shehraan/DIY_VR_Controller/Drivers/vr_controller/bin/win64/README.md

Build output target for the SteamVR driver DLL.

Expected file after build:

- `driver_vr_controller.dll`
