shehraan/DIY_VR_Controller/Hardware/Docs/Original-Prototype-Circuit-Drawing.pdf

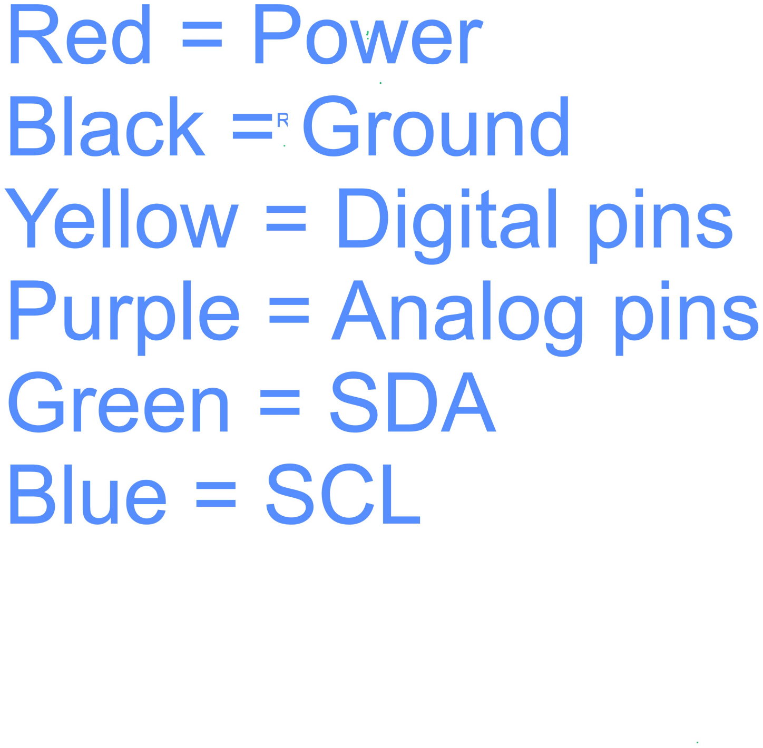
[picture p5: page 1]
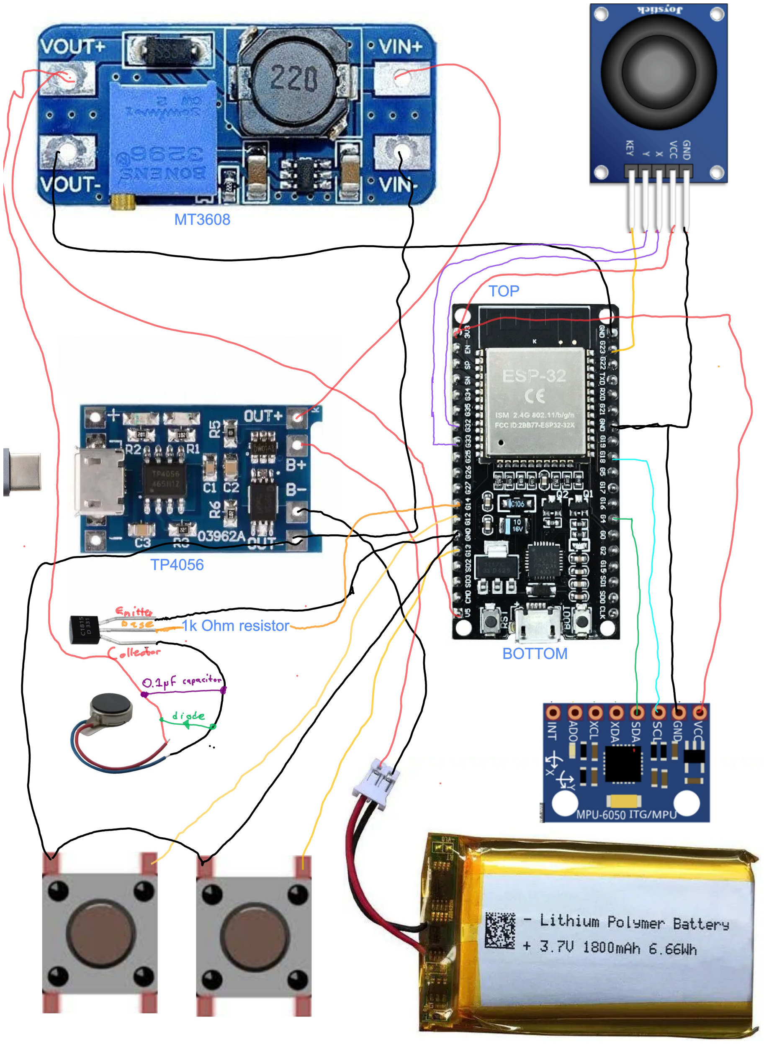
[picture p6: page 2]
