shehraan/DIY_VR_Controller/Hardware/Simulation/Motor-less Wokwi Circuit Files/Circuit Diagram.png

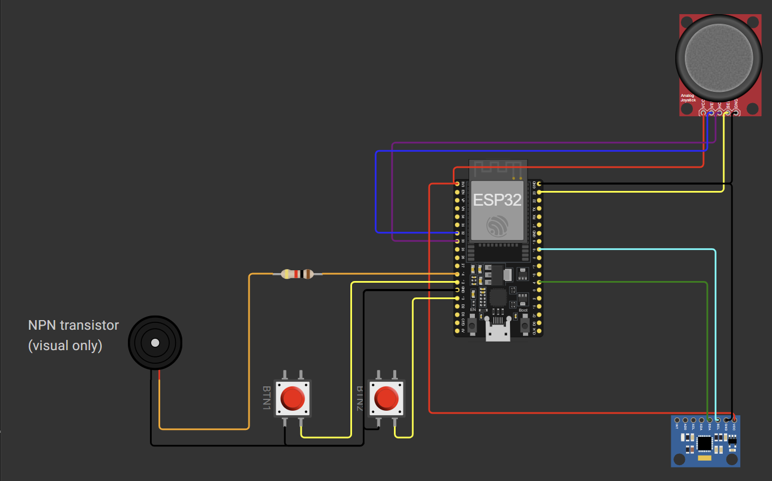
Hardware/Simulation/Motor-less Wokwi Circuit Files/Circuit Diagram.png
