shehraan/DIY_VR_Controller/Hardware/Docs/VR Controller parts list.xlsx

Part Name | Component | Full Price | Link
CPU | ESP-32 dev kit | $25 | https://a.co/d/08W9CSqC
Battery | 2000mah 103450 3.7V LiPo Battery | $20 | https://www.aliexpress.com/item/1005007520210283.html
USB-c Battery Charger | TP4056 Charging Board with Protection | $5 | https://www.aliexpress.com/item/1005006043031985.html
Joystick | PS2 Joycon KY-023 | $4.25 | https://www.aliexpress.com/item/1005006195988088.html
Vibration Motor | VC1030A002F Coin-sized DC motor | $8 | https://www.aliexpress.com/item/1005009934713982.html
Buttons | Gikfun 12x12x7.3mm Tactile Buttons | $16 | https://www.amazon.ca/Gikfun-12x12x7-3-Tactile-Momentary-Arduino/dp/B01E38OS7K
Voltage Boost Module | Mt3608 | $7 | https://www.aliexpress.com/item/1005010404367609.html
Capacitor | 100nf Ceramic Capacitor | $9.85 | https://www.amazon.ca/Tiuimk-100-0-1uF-Ceramic-Capacitor/dp/B0CFTJR3L2
Diode | 1N4001 | $10.53 | https://www.amazon.ca/Projects-General-Purpose-Silicon-Rectifiers/dp/B08JQP945V
IMU | 6DoF MPU-6050 | $3.50 | https://www.ebay.ca/itm/265931676678?chn=ps&google_free_listing_action=view_item
 | Total CAD: | $109.13
