shehraan/DIY_VR_Controller/Hardware/Docs/Controller_Schematic.pdf

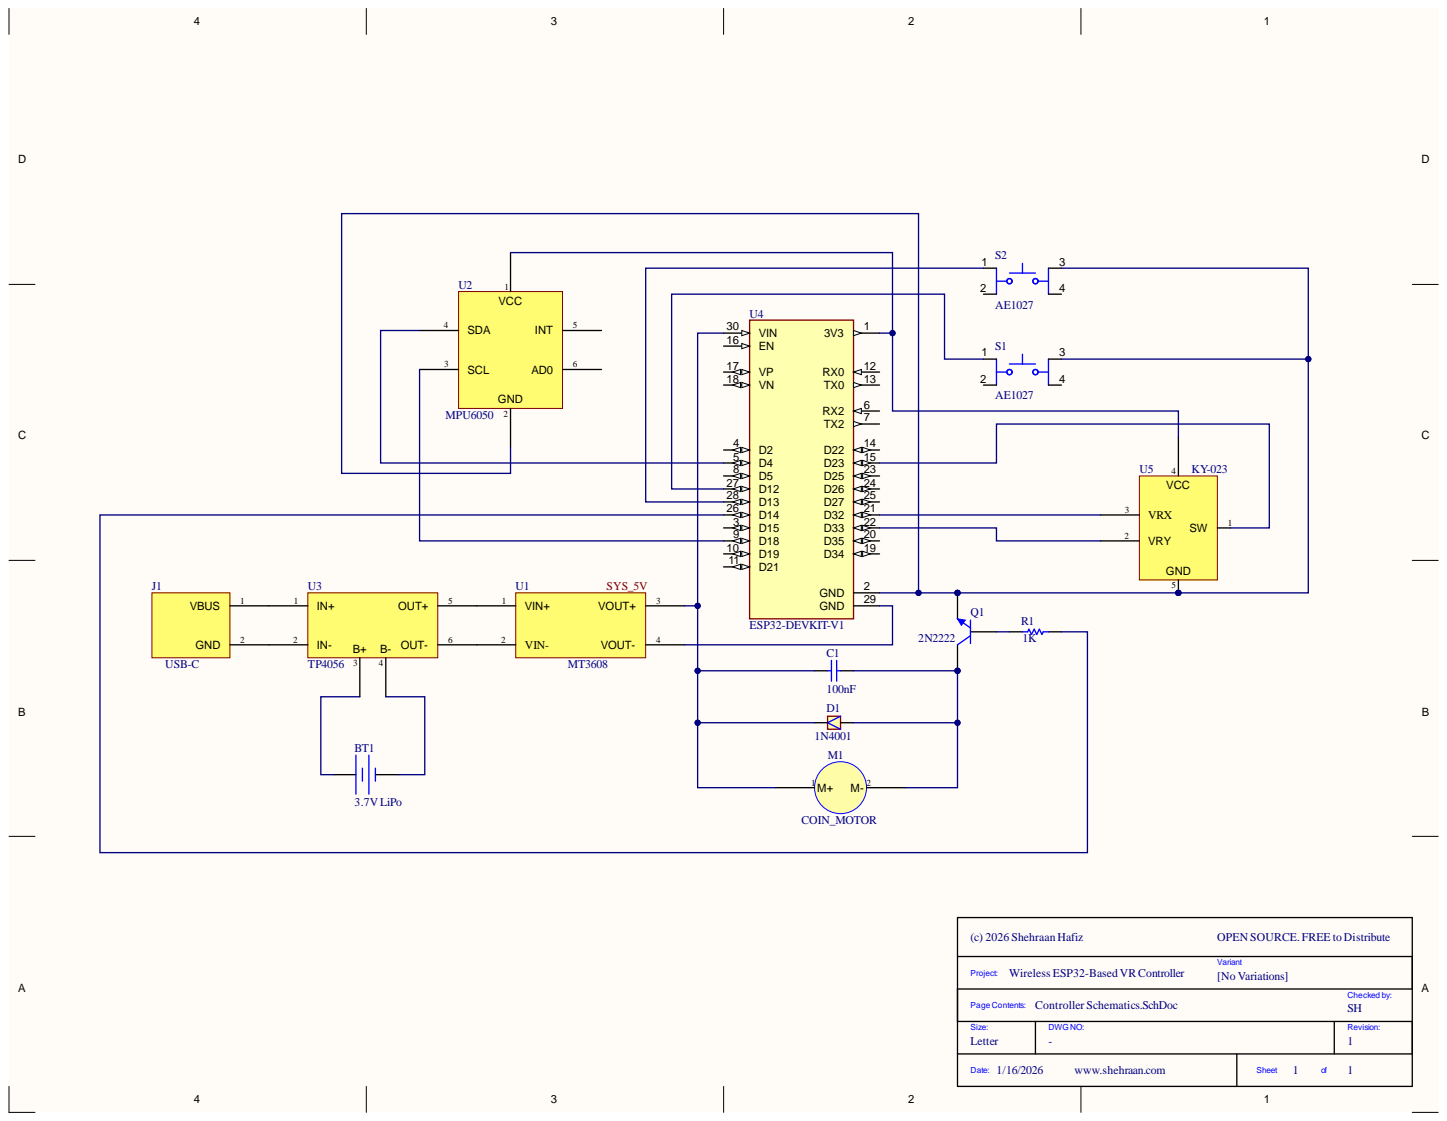
[picture p8: page 1]

OPEN SOURCE. FREE to Distribute

Wireless ESP32-Based VR Controller

Page Contents: Controller Schematics.SchDoc

Size: Letter | DWG NO: - | Revision: 1

Date: 1/16/2026 www.shehraan.com | Sheet 1 of 1
