shehraan/DIY_VR_Controller/(list of files, drawings)

Other design files:
Hardware/Altium Schematics/Schematics/Controller Schematics.SchDoc
Hardware/Altium Schematics/VR_Controller.PrjPcb
