shehraan/DIY_VR_Controller/(commit log)

2025-12-27 Began IMU configuration
2025-12-29 Add complementary sensor filtering via accelerometer corrections
    [main.cpp]
2025-12-30 Created IMU Register IO helpers and cleaned readIMU() function
2026-01-04 switch bias calibration from loop sampling to FIFO collection
2026-01-05 Implemented Madgwick Filter for sensor fusion
2026-01-05 Implemented HID Transport Module for communicating with Drivers.
2026-01-08 Implemented warmup loop, dynamic beta tuning & EEPROM-backed calibration persistence
2026-01-08 Switch HID transport to BLE-only for ESP32
2026-01-10 Added joystick and buttons support
2026-01-11 Added circuit Drawing
2026-01-11 Added image of circuit diagram
2026-01-11 Added Circuit Simulation files
2026-01-16 Added Altium-based schematics
    [Controller Schematics.SchDoc, VR_Controller.PrjPcb]
2026-01-17 Added parts list
    [VR Controller parts list.xlsx]
2026-01-17 Updated pinouts in schematics
    [Controller Schematics.SchDoc, VR_Controller.PrjPcb]
2026-01-17 Implement end-to-end HID transport (IMU, joystick, dual buttons, rumble)
2026-01-18 Added a complete python-based test suite to use before assembly
2026-01-19 Added input test file to run, prior to assembling controller
2026-01-19 Create Drivers folder and add vr_controller driver manifest file
2026-01-20 Add default driver settings
2026-01-24 Add controller protocol and driver logging headers
2026-01-26 Implement OpenVR provider and controller device
2026-02-03 Add SteamVR resource definitions for controller driver
2026-02-06 Added final built drivers.
2026-02-10 Added driver compile instructions
